thieu-b55/ESP32-webradio-easy-control/Web radio.jpg

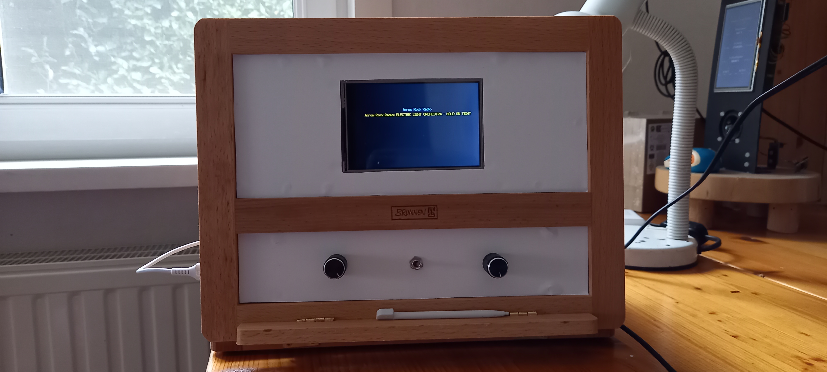
Web radio.jpg
