thieu-b55/ESP32-webradio-easy-control/README.md

# ESP32-webradio-easy-control

## for a more current version

https://github.com/thieu-b55/The---I-want-this---ESP32-S3-Internet-radio

can be operated via:

web interface

touch screen

rotary encoder

After programming once, all parameters can be adjusted via web page.

Maximum 75 radio stations can be programmed

If there is no network connection, the WiFi data can be entered via a web page, the IP address can also be chosen yourself.

Tone control possible via web page

mp3 player plays up to 8000+ mp3 files in random order.

Uses the ESP32-audioI2S library >> good sound quality
