thieu-b55/ESP32-webradio-easy-control/Use these libraries and esp32 by Espressif Systems if operation via smartphone is not possible/Readme

Operation via smartphone is almost no longer possible with the new version esp32 by Espressif Systems, 

go back to version 1.0.6, see .png screenshot

Librarie ESP32-audioI2S-master with 7z compressed in 2 part archive file, total more than 25Mb, max allowed on Github.
